Zeck69/autopilot_boat/README.md

# Autonomous Sailboat

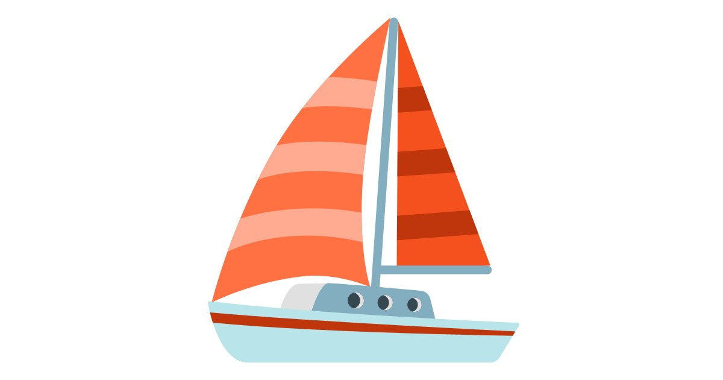
[picture p1: docs/assets/26f5.jpg]


### **A project for automating a reduced model of Sailboat.**

Find all details here : https://zeck69.github.io/autopilot_boat/

\
*Project made in the context of the course CS-358 at EPFL, under the supervision of M. Koch and M. Stella.*
