Zeck69/autopilot_boat/boat_model/README.md

# Boat Design

The design of the 3D printed boat was made by Antoine Truchot, in collaboration with our team. The files are left to modification as we provide all the SolidWorks 2021 files we created.
