Zeck69/autopilot_boat/docs/index.md

---
layout: default
title: Autonomous Sailboat
nav_order: 1
---

# **Autonomous Sailboat**

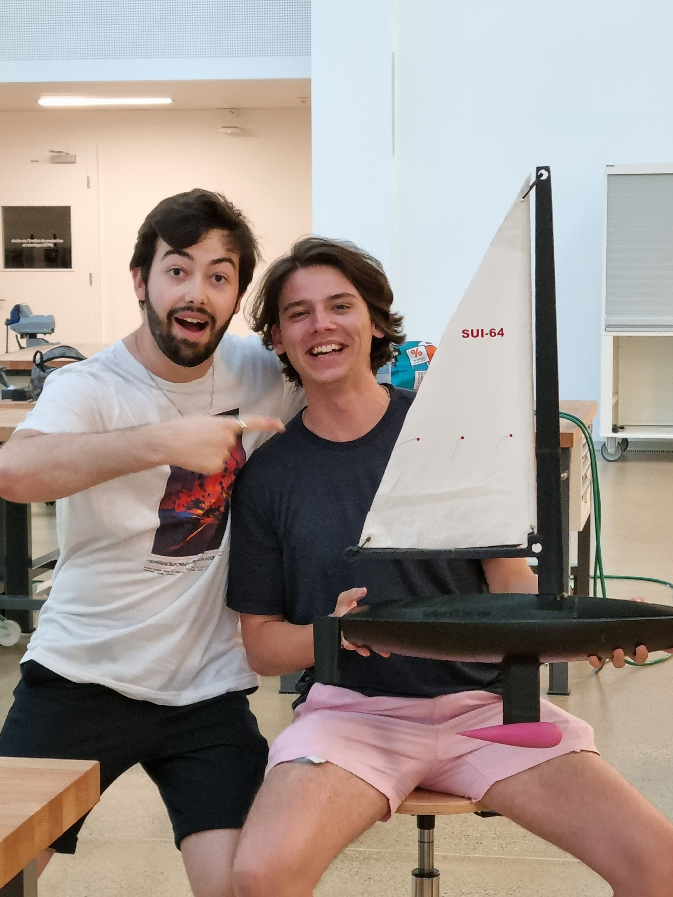
[picture p21: docs/assets/joie.jpg]
Team Joy with the Boat
 
{: .flex-justify-between}

The project is born of our **motivation to challenge ourselves**. Not only did we try to make an electronic project, but we also implemented some **mechanics**, wich was not trivial for the IC students that we are. This website is here to show you our work, as well as guidelines to build this on your own and how to take over the project for improvements.

*For the code and design files, please refer to the Github repository :*<br/>

[Github Repo](https://github.com/Zeck69/autopilot_boat){: .btn .mx-auto}
