Zeck69/autopilot_boat/boat_model/Bato.SLDASM

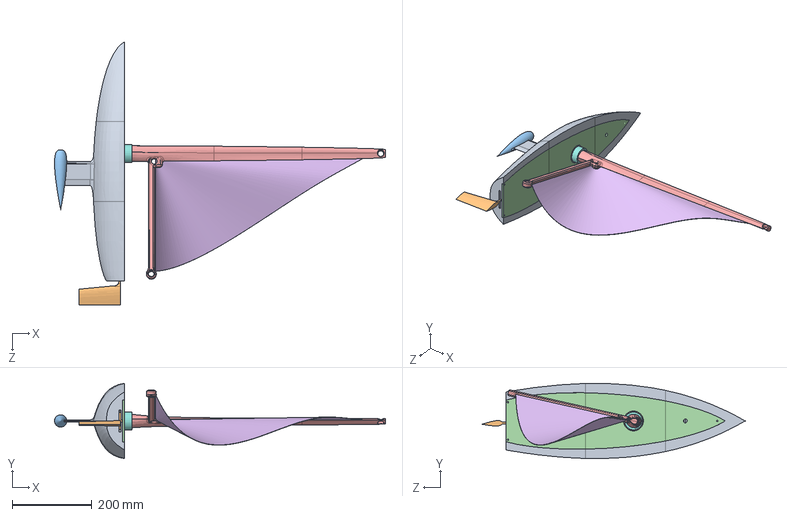
[picture p22: CAD file, 2022-06-03]
boat_model/Bato.SLDASM
830.4 x 188.2 x 660.3 mm
Coque
elgovernador
Quille
Mat
Voile
SPT5525-LV x 2
Servo_cross_lever
