Zeck69/autopilot_boat/boat_model/Voile.SLDPRT

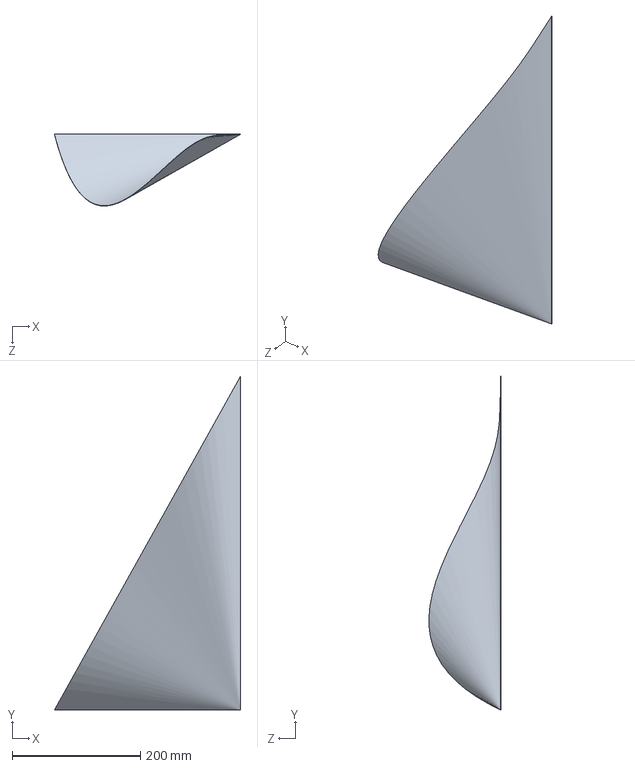
[picture p23: CAD file, 2022-06-03]
boat_model/Voile.SLDPRT
290.0 x 520.0 x 112.3 mm
