Zeck69/autopilot_boat/boat_model/elgovernador.SLDPRT

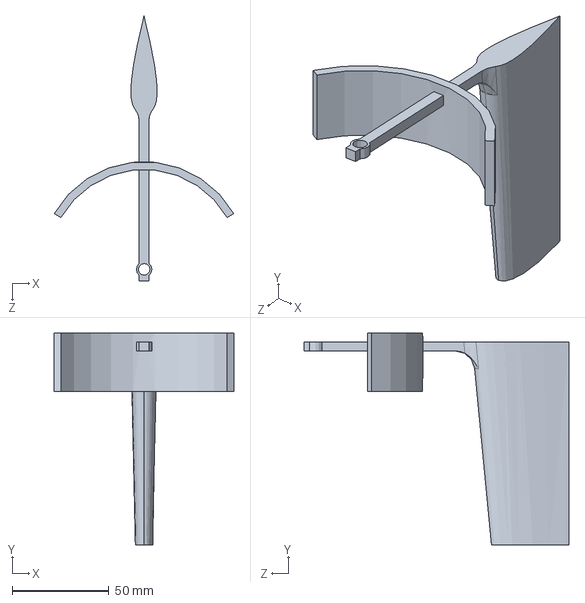
[picture p24: CAD file, 2022-06-03]
boat_model/elgovernador.SLDPRT
92.7 x 109.2 x 136.6 mm
