Zeck69/autopilot_boat/boat_model/Mat_bas_tribord.SLDPRT

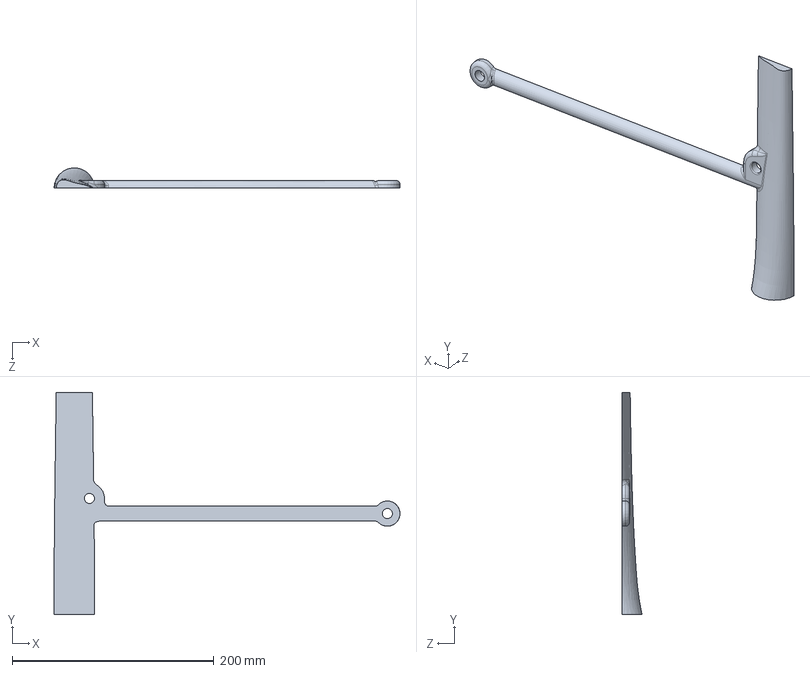
[picture p25: CAD file, 2022-06-03]
boat_model/Mat_bas_tribord.SLDPRT
342.6 x 220.0 x 19.9 mm
