Zeck69/autopilot_boat/boat_model/Coque_poupe_tribord.SLDPRT

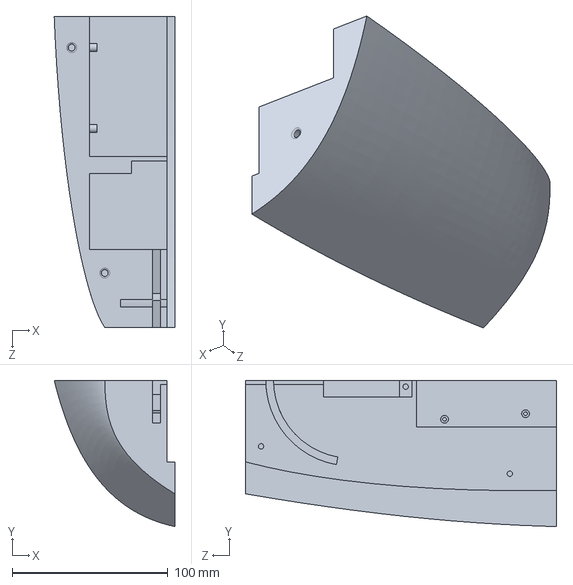
[picture p26: CAD file, 2022-06-03]
boat_model/Coque_poupe_tribord.SLDPRT
77.6 x 94.0 x 200.0 mm
