Zeck69/autopilot_boat/boat_model/Mat_haut_tribord.SLDPRT

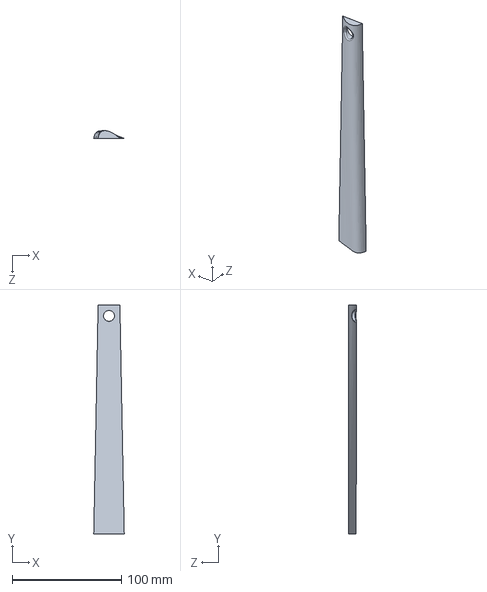
[picture p27: CAD file, 2022-06-03]
boat_model/Mat_haut_tribord.SLDPRT
28.0 x 210.0 x 7.18 mm
