Zeck69/autopilot_boat/boat_model/Mat_milieu_tribord.SLDPRT

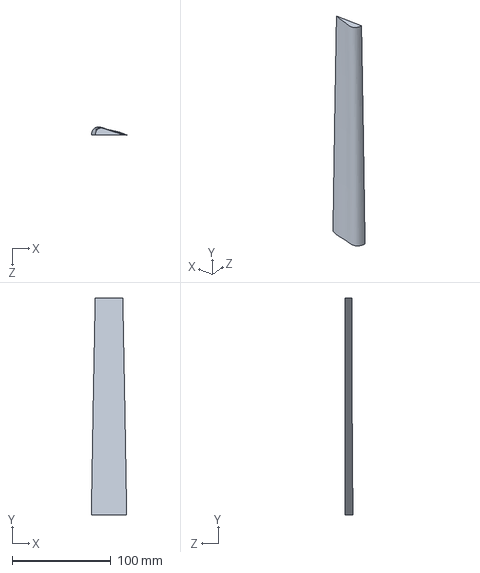
[picture p28: CAD file, 2022-06-03]
boat_model/Mat_milieu_tribord.SLDPRT
35.9 x 220.0 x 8.15 mm
