Zeck69/autopilot_boat/boat_model/Mat_puck.SLDPRT

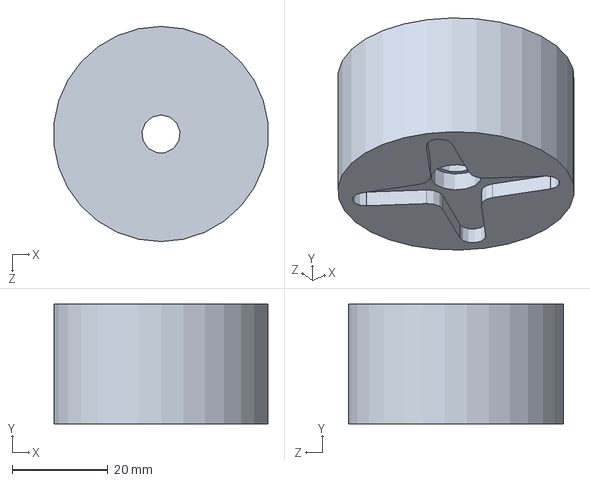
[picture p29: CAD file, 2022-06-03]
boat_model/Mat_puck.SLDPRT
44.8 x 25.0 x 45.0 mm
