Zeck69/autopilot_boat/boat_model/Coque_poupe_babord.SLDPRT

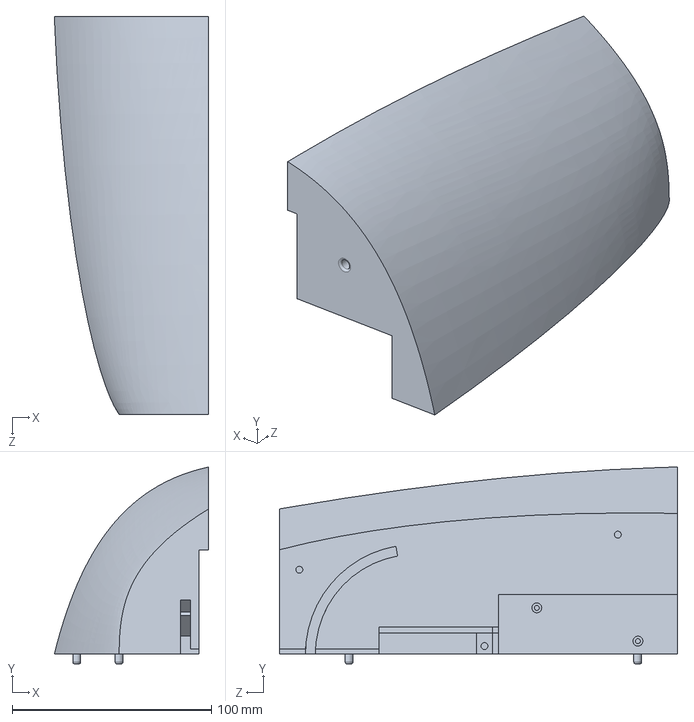
[picture p30: CAD file, 2022-06-03]
boat_model/Coque_poupe_babord.SLDPRT
77.6 x 99.0 x 200.0 mm
