Zeck69/autopilot_boat/boat_model/Girouette.SLDPRT

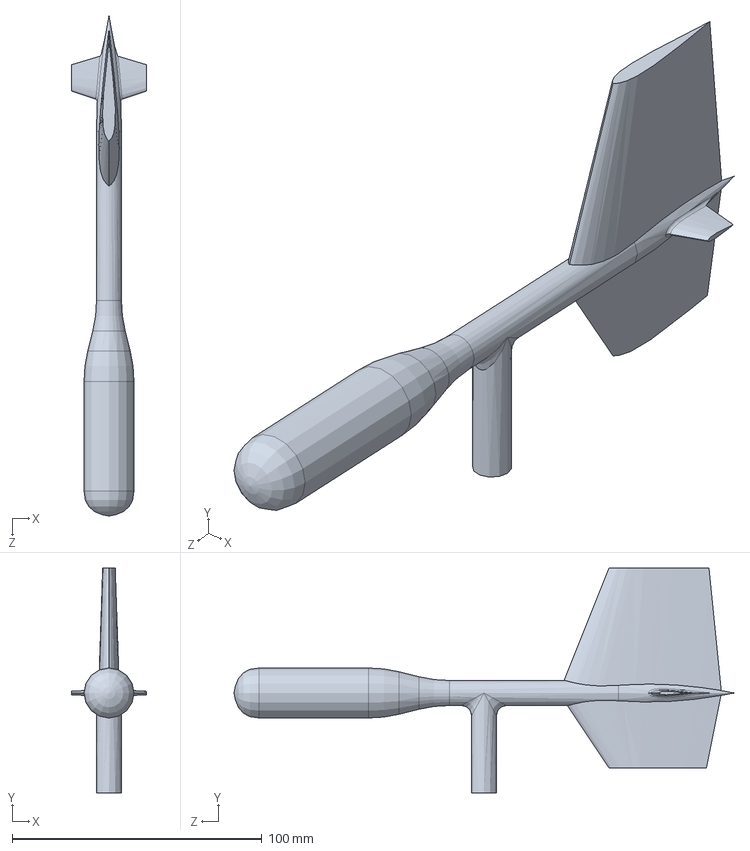
[picture p32: CAD file, 2022-06-03]
boat_model/Girouette.SLDPRT
30.0 x 90.0 x 200.0 mm
