Zeck69/autopilot_boat/boat_model/Quille.SLDPRT

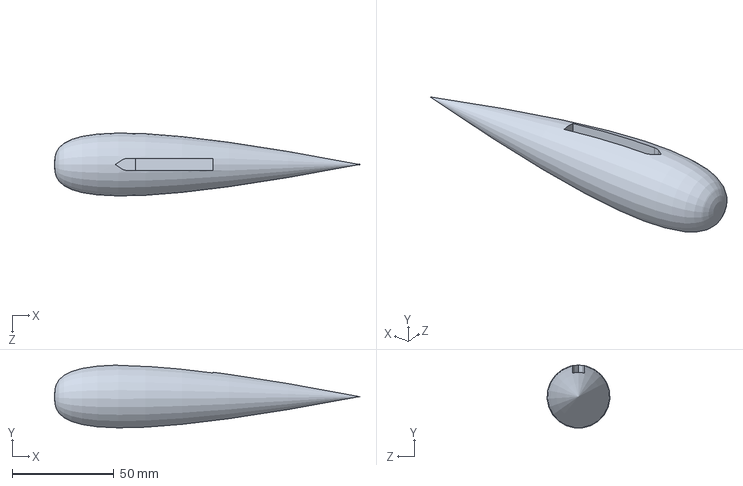
[picture p33: CAD file, 2022-06-03]
boat_model/Quille.SLDPRT
150.0 x 30.8 x 30.9 mm
