Zeck69/autopilot_boat/boat_model/Mat.SLDPRT

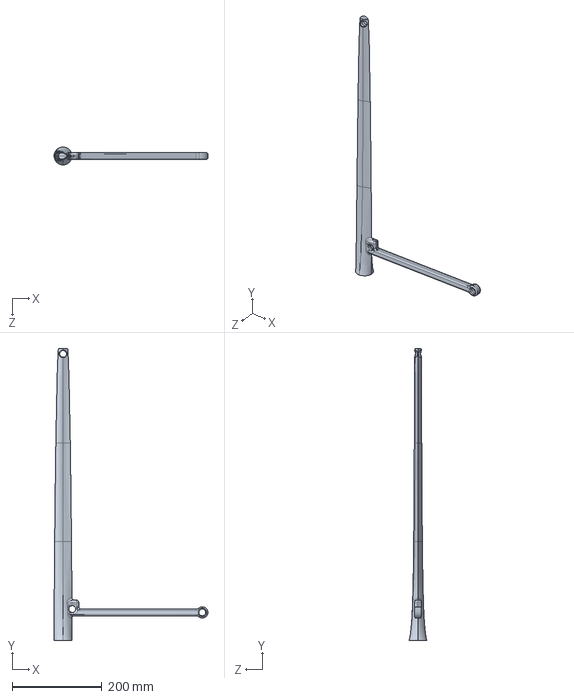
[picture p34: CAD file, 2022-06-03]
boat_model/Mat.SLDPRT
342.5 x 650.0 x 39.9 mm
