Zeck69/autopilot_boat/boat_model/Coque_milieu.SLDPRT

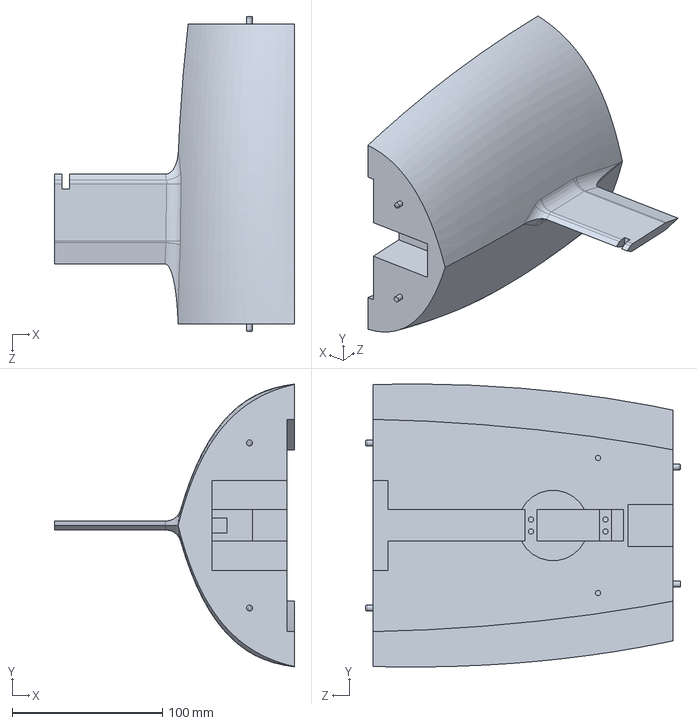
[picture p35: CAD file, 2022-06-03]
boat_model/Coque_milieu.SLDPRT
160.0 x 188.5 x 210.0 mm
