Zeck69/autopilot_boat/boat_model/Proue.SLDPRT

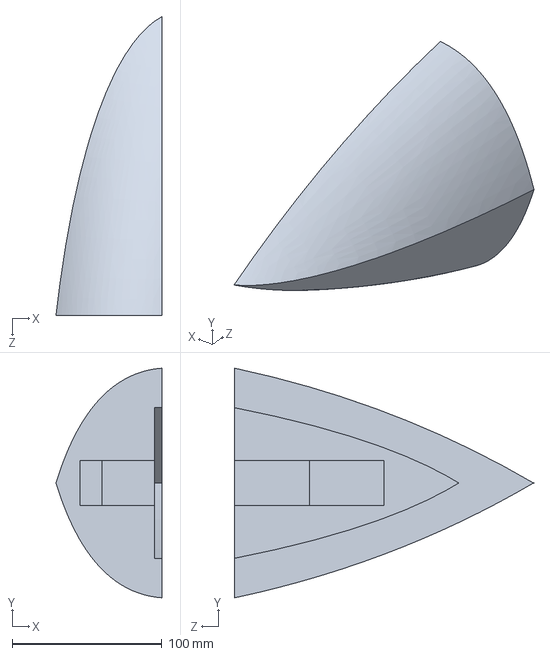
[picture p36: CAD file, 2022-06-03]
boat_model/Proue.SLDPRT
70.9 x 153.6 x 200.0 mm
