Zeck69/autopilot_boat/boat_model/Centre.SLDPRT

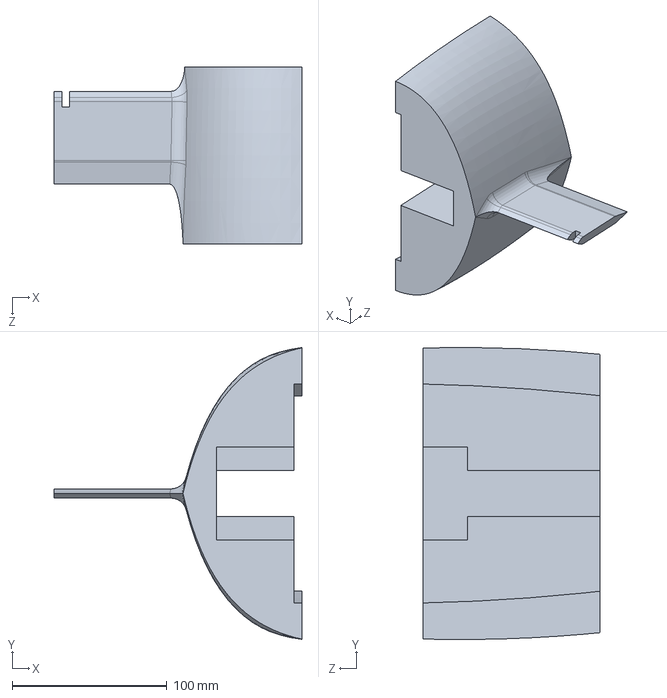
[picture p37: CAD file, 2022-06-03]
boat_model/Centre.SLDPRT
160.0 x 188.5 x 114.5 mm
