Zeck69/autopilot_boat/boat_model/SPT5525-LV.SLDPRT

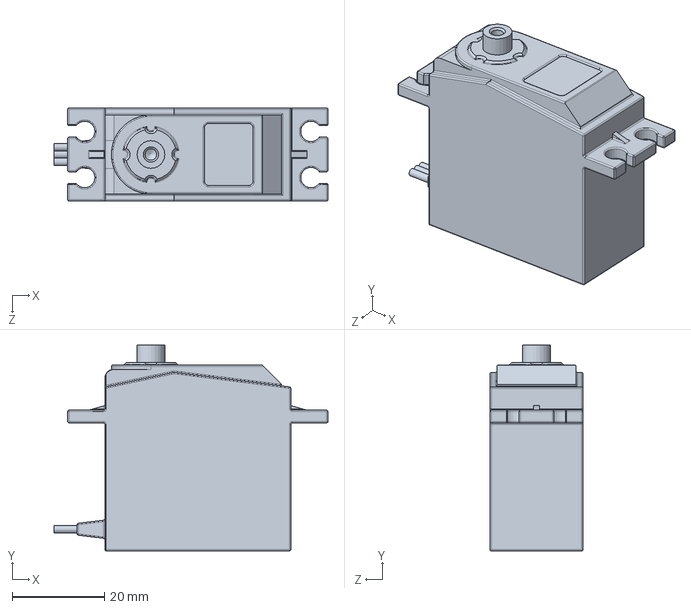
[picture p38: CAD file, 2022-06-03]
boat_model/SPT5525-LV.SLDPRT
59.4 x 44.6 x 20.1 mm
