Zeck69/autopilot_boat/boat_model/Coque.SLDPRT

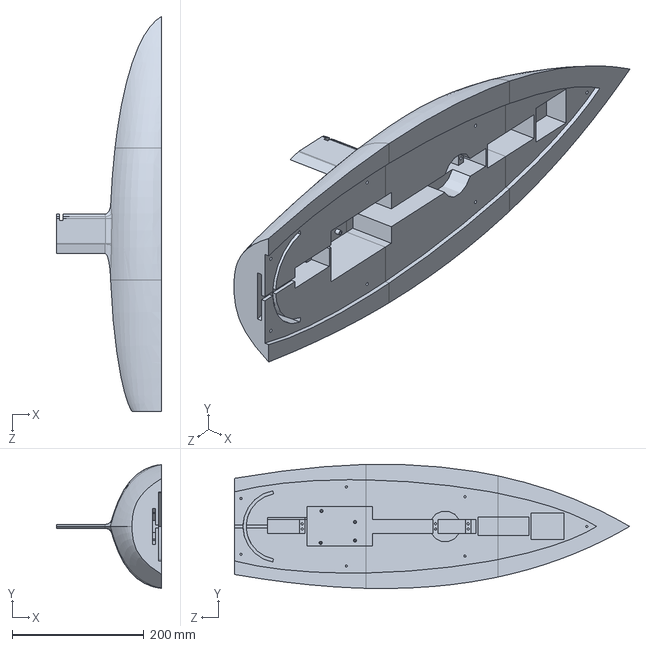
[picture p39: CAD file, 2022-06-03]
boat_model/Coque.SLDPRT
160.0 x 188.2 x 600.0 mm
