Zeck69/autopilot_boat/boat_model/Pont.SLDPRT

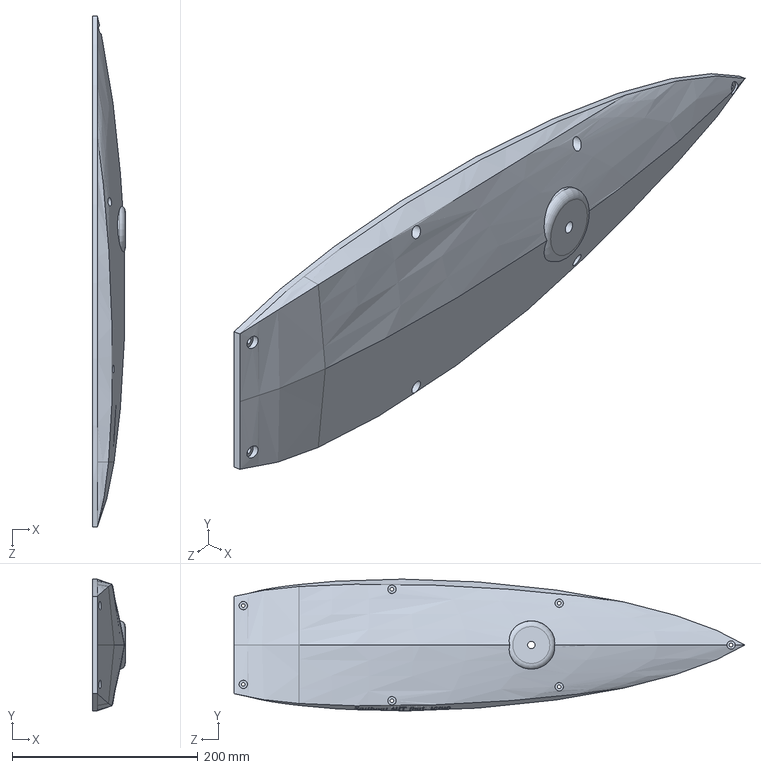
[picture p40: CAD file, 2022-06-03]
boat_model/Pont.SLDPRT
35.0 x 141.8 x 550.0 mm
