Zeck69/autopilot_boat/(list of files, cad)

Other CAD files:
boat_model/Mat_bas_babord.SLDPRT
boat_model/Mat_haut_babord.SLDPRT
