Zeck69/autopilot_boat/(commit log)

2022-05-03 Update autopilot_boat.ino
    TODO:
    - implement IMU methods (speed and angle)
    - handle turning extreme settings
    - implement servos
    - jibing and tacking
2022-05-20 all IMU + beating
2022-05-31 boat design
    [Bato.SLDASM, Centre.SLDPRT, Coque.SLDPRT, Coque_milieu.SLDPRT, Coque_poupe_babord.SLDPRT, Coque_poupe_tribord.SLDPRT, Girouette.SLDPRT, Mat.SLDPRT]
